maysamsgx/one-robot-speak-control-avoid/Project_Stage3.docx

COE304 Embedded Systems Project Proposal

Spring 2025

Hardware and Software Integration (Phase 3)

Project Name: One Robot, Endless Possibilities | Speak, Control, Avoid

Group No: 10

| Student ID | Student Name
| 210901038 | Beyza Nur Yazıcı
| 210901016 | İrem Batıgün
| 220901646 | Misem Mohamed

1. Software that meets your Requirements

Write the code for your project in C or Assembly to achieve the second stage requirements. Be specific for each one. Fill the following table.

RQ1 | 1. Measure distance using ultrasonic sensor.
| Example: This requirement has been achieved by the following code which triggers the ultrasonic sensor and reads the echo pulse duration to calculate distance in centimeters. // Trigger ultrasonic pulse and read echo time, return distance in cm int readUltrasonic() { digitalWrite(TRIG_PIN, LOW); delayMicroseconds(4); digitalWrite(TRIG_PIN, HIGH); delayMicroseconds(10); digitalWrite(TRIG_PIN, LOW); long duration = pulseIn(ECHO_PIN, HIGH); // Measure echo pulse width return duration / 29 / 2; // Convert microseconds to cm }
RQ2 | 2. Control servo motor to scan left, right, and center positions smoothly.
| Example: This requirement has been achieved by smoothly moving the servo to a target angle one degree at a time with a small delay, ensuring smooth motion. // Smoothly increment or decrement servo until reaching targetAngle void smoothServoWrite(int targetAngle) { int current = servo.read(); // Get current servo angle while (current != targetAngle) { if (current < targetAngle) current++; else current--; servo.write(current); // Move one degree at a time delay(5); // Small delay for smooth motion } }
RQ3 | 3. Perform autonomous obstacle avoidance by detecting obstacles and turning accordingly.

Example: This requirement is met by stopping if an obstacle is closer than 12 cm, backing up, scanning left and right distances, then turning toward the side with more space.

// Continuously check distance ahead and steer around obstacles

void autonomousObstacleAvoidance() {

int frontDistance = readUltrasonic(); // Measure distance ahead

if (frontDistance <= 12) { // If obstacle is closer than 12 cm

stopMotion(); // Stop forward motion

moveBackward(); // Back up slightly

delay(100);

stopMotion();

// Scan left and right distances by moving servo

int leftDistance = scanAt(LEFT_ANGLE);

int rightDistance = scanAt(RIGHT_ANGLE);

smoothServoWrite(CENTER_ANGLE); // Re-center servo

delay(200);

// Turn toward the side with more free space

if (leftDistance > rightDistance) {

Serial.println("Turning left");

turnLeft();

} else {

Serial.println("Turning right");

turnRight();

}

delay(TURN_DURATION_MS); // Run turn long enough for ~90°

stopMotion();

delay(200);

}

else {

moveForward(); // No obstacle → keep moving forward

}

}
RQ4 | 4. Control four DC motors for forward, backward, left, right, and stop motions.

Example: This requirement is fulfilled by functions that run the motors in the appropriate directions using the Adafruit Motor Shield library.

// Drive all four motors forward

void moveForward() {

motor1.run(FORWARD); motor2.run(FORWARD);

motor3.run(FORWARD); motor4.run(FORWARD);

}

// Drive all four motors backward

void moveBackward() {

motor1.run(BACKWARD); motor2.run(BACKWARD);

motor3.run(BACKWARD); motor4.run(BACKWARD);

}

// Spin in place to the right: left wheels backward, right wheels forward

void turnRight() {

motor1.run(BACKWARD); motor2.run(BACKWARD);

motor3.run(FORWARD); motor4.run(FORWARD);

}

// Spin in place to the left: left wheels forward, right wheels backward

void turnLeft() {

motor1.run(FORWARD); motor2.run(FORWARD);

motor3.run(BACKWARD); motor4.run(BACKWARD);

}

// Stop all motors immediately

void stopMotion() {

motor1.run(RELEASE); motor2.run(RELEASE);

motor3.run(RELEASE); motor4.run(RELEASE);

}
RQ5 | 5. Accept manual movement commands via serial input and execute corresponding actions.

Example: This requirement is met by reading serial input characters and calling movement functions based on the command received.

void loop() {

// If a byte arrives on Serial, handle it as a manual command

if (Serial.available() > 0) {

char cmd = Serial.read(); // Read single character

Serial.print("Command received: ");

Serial.println(cmd);

handleCommand(cmd); // Execute manual control

}

else {

autonomousObstacleAvoidance(); // No command → do obstacle avoidance

}

}

// Interpret Bluetooth or voice command characters

void handleCommand(char c) {

switch (c) {

case 'F': case '^': // 'F' or '^' means go forward

Serial.println("Forward");

moveForward();

break;

case 'B': case '-': // 'B' or '-' means go backward

Serial.println("Backward");

moveBackward();

break;

case 'L': case '<': // 'L' or '<' means turn left

Serial.println("Left");

turnLeft();

break;

case 'R': case '>': // 'R' or '>' means turn right

Serial.println("Right");

turnRight();

break;

case 'S': case '*': // 'S' or '*' means stop

Serial.println("Stop");

stopMotion();

break;

default: // Any other char → emergency stop

stopMotion();

break;

}

}
RQ6
| 6. Set motor speed to a fixed PWM value for consistent movement.
| Example: This requirement is achieved by setting the speed of all motors to 180 during setup. #define MOTOR_SPEED 180 // PWM speed for all four DC motors (0–255) // Initialize all motors at defined speed motor1.setSpeed(MOTOR_SPEED); motor2.setSpeed(MOTOR_SPEED); motor3.setSpeed(MOTOR_SPEED); motor4.setSpeed(MOTOR_SPEED);
RQ7 | 7. Provide serial feedback on received commands.
| Example: This requirement is met by printing the received command and action to the serial monitor. char cmd = Serial.read(); // Read single character Serial.print("Command received: "); Serial.println(cmd);
RQ8 | 8. Provide a default safe state when unknown commands are received.
| Example: The system stops all motors immediately if an unrecognized command is received, preventing unsafe behavior. default: // Any other char → emergency stop stopMotion(); break;
RQ9 | 9. Use delays appropriately to allow hardware to settle and avoid timing issues.
| Example: Delays after servo movement and motor commands ensure sensors and actuators have time to respond. // Wait after servo moves before reading sensor to Run turn long enough for ~90° delay(TURN_DURATION_MS); // Allow servo to settle delay(SCAN_DELAY_MS);
RQ10 | 10. Modularize code for clarity and maintainability.
| Example: Each functionality (movement, scanning, command handling) is encapsulated in dedicated functions, improving readability and testability. void scanAt(int angle) { ... } void smoothServoWrite(int targetAngle) {…} void handleCommand(char c) { ... } void autonomousObstacleAvoidance() {...} void moveForward() { ... } void moveBackward() {…} void turnRight() {...} void turnLeft() {…} void stopMotion() {…}
RQ11 | 11. System shall operate continuously without manual reset.
| Example: The loop() function runs indefinitely, continuously checking for commands or performing autonomous navigation. void loop() { // If a byte arrives on Serial, handle it as a manual command if (Serial.available() > 0) { char cmd = Serial.read(); // Read single character Serial.print("Command received: "); Serial.println(cmd); handleCommand(cmd); // Execute manual control } else { autonomousObstacleAvoidance(); // No command → do obstacle avoidance } }

2. HW and SW Integration

Integrate the hardware components with the Arduino board and uploading the code to the board for testing. Write down any challenge or error you faced and how did you solve it.

| Challenge or Error | How did you solve it?

Bluetooth Module Availability and Hardware Compatibility

Initially, we were unable to find the Bluetooth module in local markets, as it was frequently out of stock. As a temporary solution, we borrowed an ESP32 Wi-Fi + Bluetooth module. Upon researching its specifications, we found that it offered superior performance compared to the HC-05. However, it also required a more complex wiring setup, which did not align well with our existing design. To maintain our original hardware layout, we eventually sourced an HC-05 module. This module also required soldering in order to interface with the motor driver shield, but compared to the DC motor connections, the soldering process was significantly simpler and more straightforward.

Encoder Disc

Absence

To address the encoder disk shortage, we carefully measured the only available encoder disk and recreated its exact geometry using ShapeWorks. After finalizing the design, we utilized a 3D printer to fabricate four new encoder disks based on the model. This approach allowed us to successfully replicate all the encoder disks, using just a single physical sample as a reference.

However, we initially implemented the encoder without thoroughly researching its purpose and functionality. Later, we realized that our project does not require advanced features such as:

- Precise distance measurement (e.g., moving exactly 30 cm),
- Linear positioning or navigation,
- Speed control or PID motor control,
- Simultaneous Localization and Mapping (SLAM),
- Odometric position tracking.

Despite this, we decided to retain the newly designed encoder disks in our build to support future development and potential feature expansion. By doing so, we ensured our design remains flexible and scalable should more complex capabilities be added later.
| Lack of Screws | The package we received was missing the screws required to mount the motors, which caused difficulties in securing them to the chassis. There were several alternative solutions, such as using super glue, tying the motors to the chassis with plastic cable ties, or sourcing replacement screws. Ultimately, we chose to purchase or borrow the correct screws, as this was the most reliable and durable option for ensuring mechanical stability.
| Shipping Damage on L293D Shield | The pins of the L293D motor driver shield arrived bent due to shipping damage. To straighten them without causing further damage, we used a pair of needle-nose pliers. This allowed us to carefully realign the bent pins without breaking or weakening them.
| A Detached Ground Wire In the Servo Motor | Although we tested it and confirmed it was working, we decided to use a brand-new servo, as we believed the condition of the wire could lead to potential inconsistencies.
| Stability of the Ultrasonic Sensor and Servo Motor | The ultrasonic sensor was required to be mounted on top of the servo motor, making the servo act as the structural base. Therefore, it needed to be firmly secured. We achieved this by fastening it to the car chassis using multiple screws and the pre-drilled mounting holes. To mount the ultrasonic sensor itself, we utilized a dedicated holder, which allowed attachment to the servo using double-sided adhesive tape. However, ensuring mechanical balance was challenging, the setup frequently tipped forward or backward during operation, requiring repeated adjustments to maintain stability.

Not pre-wired DC Motors

The DC motors we received did not come with pre-attached wires, so we had to manually solder the connections. In order to perform proper soldering, we first familiarized ourselves with basic soldering techniques, including tinning the wire tips, preheating the joint area, and applying the solder to the heated surfaces rather than the iron directly. However, during the initial soldering process, we overlooked critical aspects such as wire polarity and color orientation. This oversight led to a wiring mismatch, which we only identified later when we faced difficulties connecting the motors to the motor driver. As a result, we had to desolder the initial connections and perform a second round of soldering, this time ensuring correct polarity alignment and mechanically stable joints to guarantee reliable motor driver operation

Challenges in Connecting DC Motors to Motor Shield

Connecting the DC motors to the motor shield proved to be a time-consuming task, mainly due to the lack of clear and consistent tutorials or documentation. We struggled to determine the correct wiring order and polarity for the motor terminals, and it was unclear how critical the wire sequence was. In some reference materials, the middle terminal was shown as a pinned GND, making it inaccessible—yet in our version, the layout differed, further adding to the confusion. We were forced to try multiple wiring combinations through trial and error to identify the correct configuration. Additionally, due to inconsistent soldering and poor tip shaping on the wire ends, inserting the wires into the shield terminals was physically difficult, often resulting in unstable or unreliable connections. During this process, the wheels often rotated in the wrong direction or failed to move altogether, which significantly delayed our progress.
| Upload Failure Due to Serial Pin Interference (D0/D1 Conflict) | After completing our connections and attempting to upload the code to the Arduino, the upload consistently failed despite all our validations. Upon further investigation, we discovered the issue was caused by a common mistake: something was connected to pins D0 (RX) and D1 (TX) during the upload process. These pins are used for serial communication between the Arduino and the computer and must remain unconnected when uploading code. In our case, the Bluetooth module was still attached to those pins, which interfered with the upload process.

Servo Malfunction Due to Timer Conflict on Motor Shield

We initially connected our servo motor to the SERVO_1 port on the motor shield, but it didn’t function correctly. Upon further research, we found that on motor shields like the Adafruit Motor Shield v1/v2, certain pins serve special purposes. The SERVO_1 and SERVO_2 ports are designated for servo output and are compatible with the Servo library. However, pins like D9 and D10 can lead to conflicts when used with both motors and servos, as they share the same internal timer. In our case, connecting the servo to SERVO_1 (Arduino pin 10) caused such a conflict. The recommended solution was to switch the connection to SERVO_2 (Arduino pin 9), which is better suited for servo control without timing conflicts. After doing so, the servo operated as expected.

Connection problem with Bluetooth module

The Bluetooth module we purchased did not ask for a PIN code on first use and could not be configured in any way. After researching, we found that it might be a clone, which can cause such issues. Therefore, we borrowed another module, but even though this one was original, we still faced connection problems. When we couldn’t solve the issue ourselves, we asked you for help, and you showed us that Bluetooth can often cause unexpected issues — there are even special debugging tools made just for this. You reset the Bluetooth pairing on the phone and re-paired it, which resolved the problem. Since then, we have not experienced any further issues.

Forget to buy a switch – the robot couldn’t be stopped without removing the battery, and autonomous behavior was disrupted

We solved this purely in software with two approaches:
1. On-demand autonomy – In loop() we check Serial.available(). If there’s input, we call handleCommand(cmd) (forward/back/left/right/stop); if not, we call autonomousObstacleAvoidance(). This both disables obstacle avoidance during manual control and provides an emergency-stop path without pulling the battery.
2. Explicit modes – Maintain a mode variable (Obstacle / Bluetooth / Voice) and switch on special commands. We rejected this due to added state-machine complexity.
We chose option 1 for its simplicity, seamless hand-off, built-in emergency stop, and easier debugging (all logic in one control flow).

3. Testing and Debugging:

Emphasize the importance of testing each component and functionality of the project code thoroughly to identify and fix any errors or bugs (if any). You can add photos or videos.

Thorough testing and debugging of each component is a critical step in embedded systems development. It ensures system reliability, correct behavior, function and smooth integration of all modules. In our project, we followed a modular approach to verify the functionality of each part individually before combining them.

1. Servo Motor Testing

We began by testing the servo motor, which is responsible for carrying the ultrasonic sensor to scan the environment left and right for obstacle detection. We wrote a script to sweep the servo from 0° to 180° and back in 1° increments. This allowed us to confirm that the servo responds smoothly and consistently to angle commands.

Observation: The motor arm rotated as expected, demonstrating that the pin connection (D9), PWM signal, and power supply were functioning correctly.

Result: No jittering or delays were observed, verifying that the servo could later be used for scanning in the robotic car.

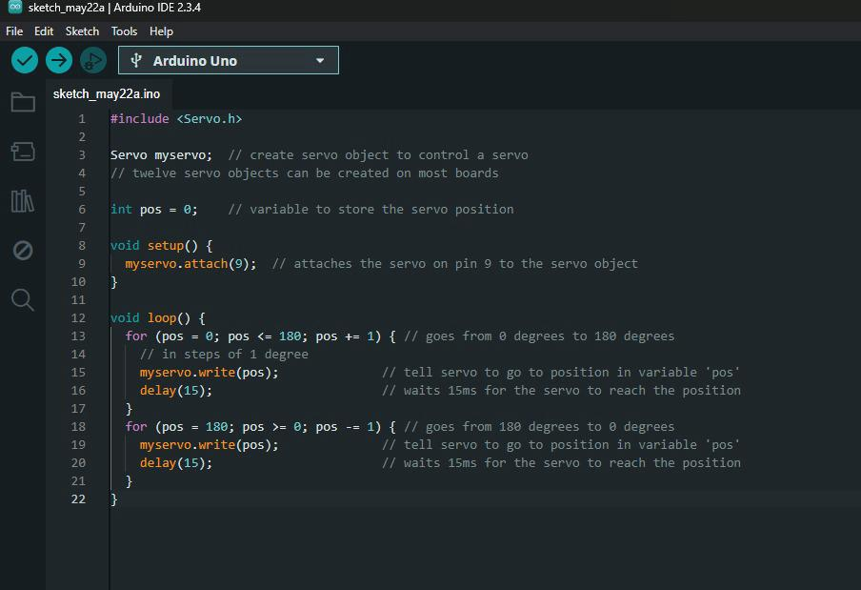
[picture p3: figure]
metin, ekran görüntüsü, yazılım, multimedya yazılımı içeren bir resim Yapay zeka tarafından oluşturulan içerik yanlış olabilir.

Link to video with test result of Servo Motor: https://istinye-my.sharepoint.com/:v:/g/personal/210901038_stu_istinye_edu_tr/EW9BHaciSRtEtWb2v8HnXpIBxT5TJh-lczQ1BDwhIgzclA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

2. Ultrasonic Sensor Testing

Next, the ultrasonic sensor (HC-SR04) was tested independently to verify its ability to accurately detect distances. A simple Arduino sketch was used to trigger the sensor and display real-time distance measurements on the Serial Monitor. This test helped identify any potential wiring or signal issues before integrating the sensor into the full system.

Observation: When a stick was moved closer, the values on the monitor changed in real time.

Result: The sensor accurately detected distances, ranging from a few centimeters to over 400 cm.

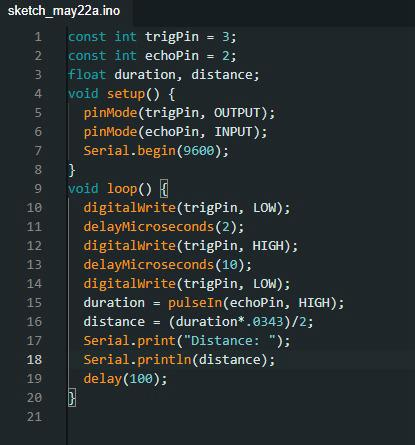
[picture p4: figure]
metin, ekran görüntüsü, yazı tipi içeren bir resim Yapay zeka tarafından oluşturulan içerik yanlış olabilir.
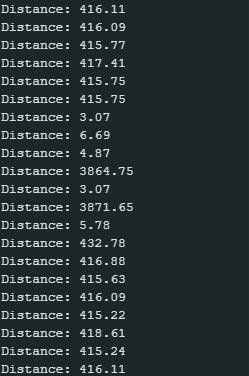
[picture p5: figure]
metin, ekran görüntüsü, menü, siyah beyaz içeren bir resim Yapay zeka tarafından oluşturulan içerik yanlış olabilir.

Link to video with test result of Ultrasonic Sensor : https://istinye-my.sharepoint.com/:v:/g/personal/210901038_stu_istinye_edu_tr/EaSmJB6na35IiEGWLtGp92YBGHqrj38f1gEFiwWb9j1QCA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

3. Bluetooth Module Testing

Bluetooth module (HC-05), which facilitates wireless control of the robotic car via smartphone. This test was essential to ensure stable serial communication and proper pairing functionality before system integration.

Test Method: We used a simple program to turn an LED on/off by sending '1' and '0' via the serial monitor or Bluetooth terminal app.

Observation: The green LED toggled successfully in response to commands. The RX/TX communication with the HC-05 was verified through the blinking onboard LED on the module.

Result: This confirmed successful Bluetooth pairing and serial data reception.

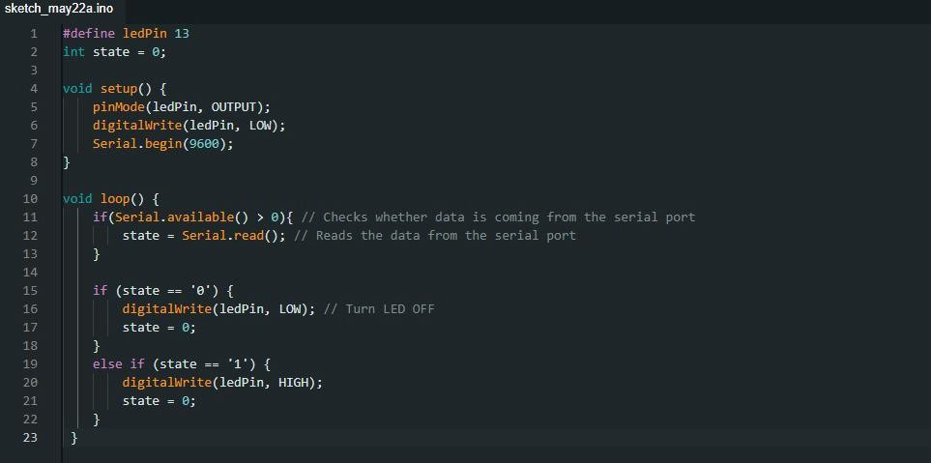
[picture p6: figure]
metin, ekran görüntüsü, yazılım, multimedya yazılımı içeren bir resim Yapay zeka tarafından oluşturulan içerik yanlış olabilir.
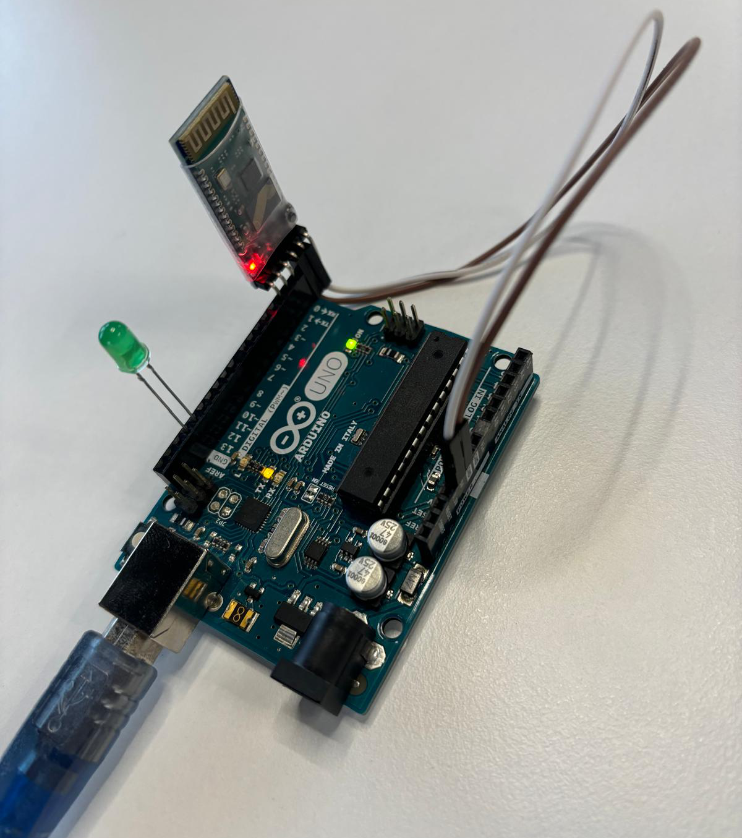
[picture p7: figure]
elektronik mühendisliği, elektronik donanım, devre bileşeni, elektronik bileşen içeren bir resim Yapay zeka tarafından oluşturulan içerik yanlış olabilir.

4. DC Gear Motor Testing

The DC motors arrived without wires, so we soldered wires to the motor terminals to enable connectivity. Then, we soldered the other ends of the wires to allow connection to the motor shield. This ensured a reliable and durable connection between the motors and the shield for consistent power delivery and control.

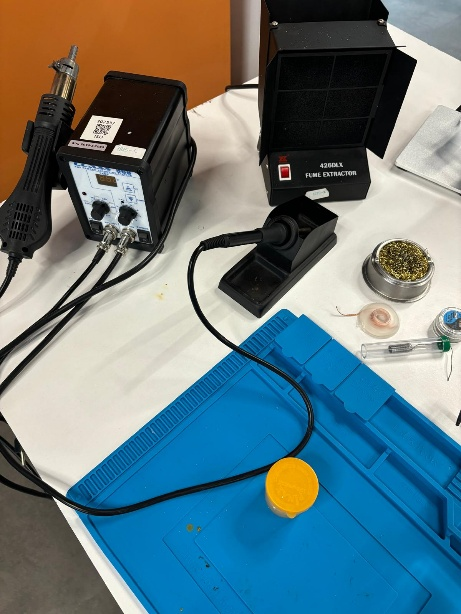
[picture p8: figure]
iç mekan, kablo, bilgisayar, ofis malzemesi içeren bir resim Yapay zeka tarafından oluşturulan içerik yanlış olabilir.
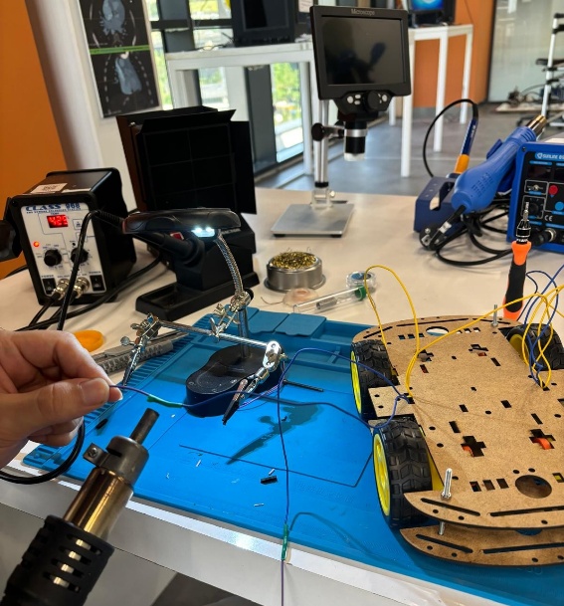
[picture p9: figure]
iç mekan, makine, alet, mühendislik içeren bir resim Yapay zeka tarafından oluşturulan içerik yanlış olabilir.
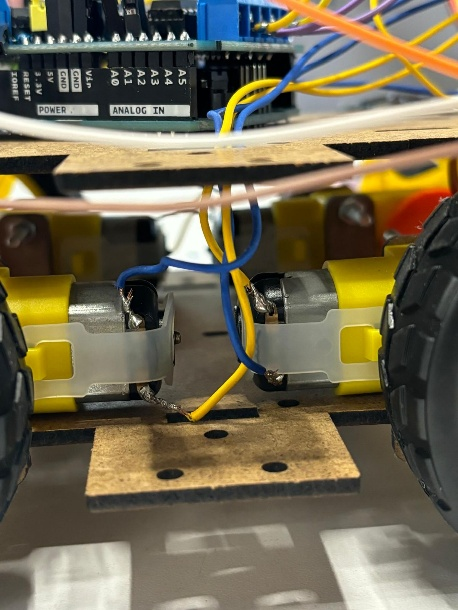
[picture p10: figure]
araba lastiği, tekerlek, Araba parçası, makine içeren bir resim Yapay zeka tarafından oluşturulan içerik yanlış olabilir.
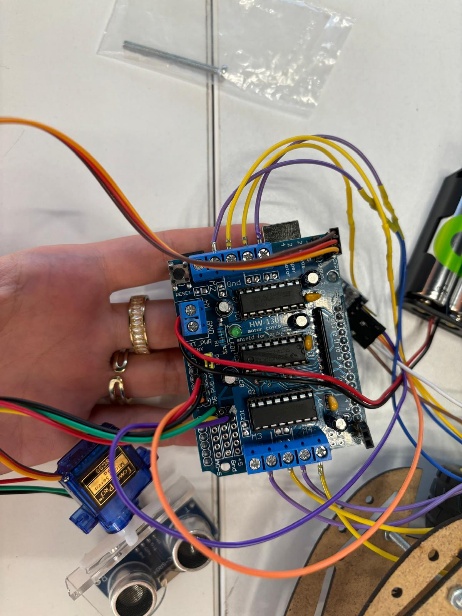
[picture p11: figure]
elektronik mühendisliği, elektronik donanım, Elektrik kabloları, devre içeren bir resim Yapay zeka tarafından oluşturulan içerik yanlış olabilir.

To validate the movement and control logic of the robotic car, we performed isolated testing of the four DC gear motors.

Test Procedure:

We created a loop that commands the car to:

Turn right for 5 seconds, turn left for 5 seconds, move backward for 5 seconds and move forward for 5 seconds. Between each action, the car stops momentarily to ensure clear transitions.

Observations: All motors responded correctly to their respective direction commands. The car performed each movement (turns and straight motion) accurately without any delay or missed signals.

Serial prints (e.g., "Turning left", "Moving forward") confirmed the execution flow in real-time through the Serial Monitor.

Results: Motor polarity and wiring are correctly configured.

The robotic car is physically capable of executing the full set of movement commands (forward, backward, left, right, stop).

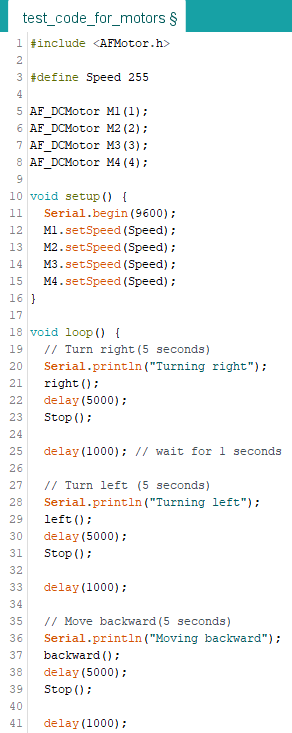
[picture p12: figure]
metin, ekran görüntüsü, yazı tipi, sayı, numara içeren bir resim Yapay zeka tarafından oluşturulan içerik yanlış olabilir.
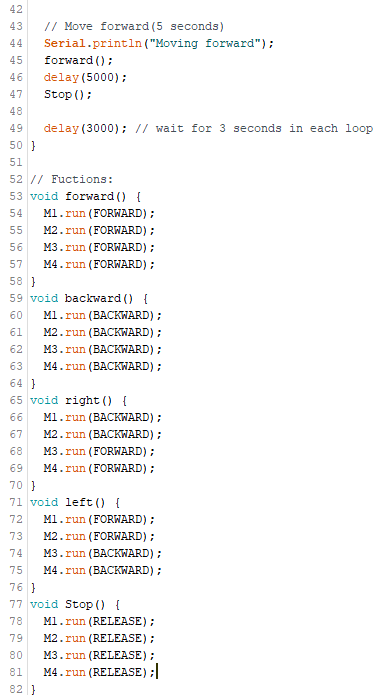
[picture p13: figure]
metin, ekran görüntüsü, sayı, numara, yazı tipi içeren bir resim Yapay zeka tarafından oluşturulan içerik yanlış olabilir.

Link to video with test result of DC Gear Motor : https://istinye-my.sharepoint.com/:v:/g/personal/210901038_stu_istinye_edu_tr/EY8MHk5t5SxEvHujQW8FcQEBdrNx3HKMUmJ0mkOIEWiACQ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

5. Battery and Power Supply Testing

Power supply is one of the most critical elements in embedded and mobile robotics projects, as it directly affects the reliability, performance, and safety of the entire system. For our robotic car, which integrates all components of the robotic car, stable and sufficient power is essential for proper, consistent and safe operation. Before integrating the battery pack into the mobile system, we conducted controlled testing using a regulated DC power supply to simulate expected voltage loads.

In the lab setup (as shown in the photo), we powered the system using a bench power supply set to 6V. This allowed us to monitor the real-time voltage and current drawn by the motors and logic components. The multimeter ensured that voltage fluctuations reducing the risk of hardware damage.

After confirming that the system could operate stably at 6V, we switched to a battery pack (4x1.5V AA batteries) as the portable power source for the car. The battery output was verified to match the voltage requirements of the motor driver and the Arduino board. Stable operation from both power sources confirmed that our wiring, voltage levels, and consumption were within safe limits.

Key Checks Performed:

- Verified 6V from the lab power supply to match motor and controller requirements.
- Ensured all motors responded with sufficient torque under load.

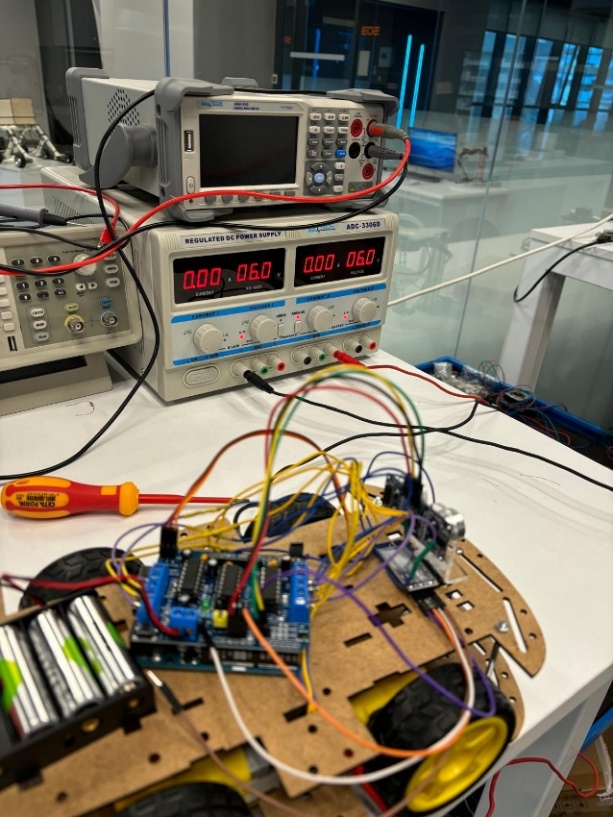
[picture p14: figure]
elektronik donanım, elektronik mühendisliği, Elektrik kabloları, kablo içeren bir resim Yapay zeka tarafından oluşturulan içerik yanlış olabilir.

4. Documentation: document your project, including
- The circuit diagram

We constructed our robotic car system according to the Fritzing circuit diagram we made in the 2nd Satge of the Project. This schematic guided the correct wiring and integration of all major components, including the Arduino Uno board, HC-05 Bluetooth module, servo motor, ultrasonic sensor, L293D motor driver shield, and gear motors powered by four Li-ion batteries.

Each connection was carefully made to ensure proper communication and power delivery between the components. The motor driver shield was placed on top of the Arduino Uno to control the four DC gear motors, while the Bluetooth module enabled wireless control. The ultrasonic sensor, mounted on a servo motor, provided real-time environmental scanning for obstacle avoidance.

In addition to the circuit schematic, we have also included real images of the final assembled car. These images highlight the physical placement of all components, including the battery holder, sensor modules, wiring setup, and chassis structure. This final prototype reflects a successful translation of our digital design into a functional embedded system.

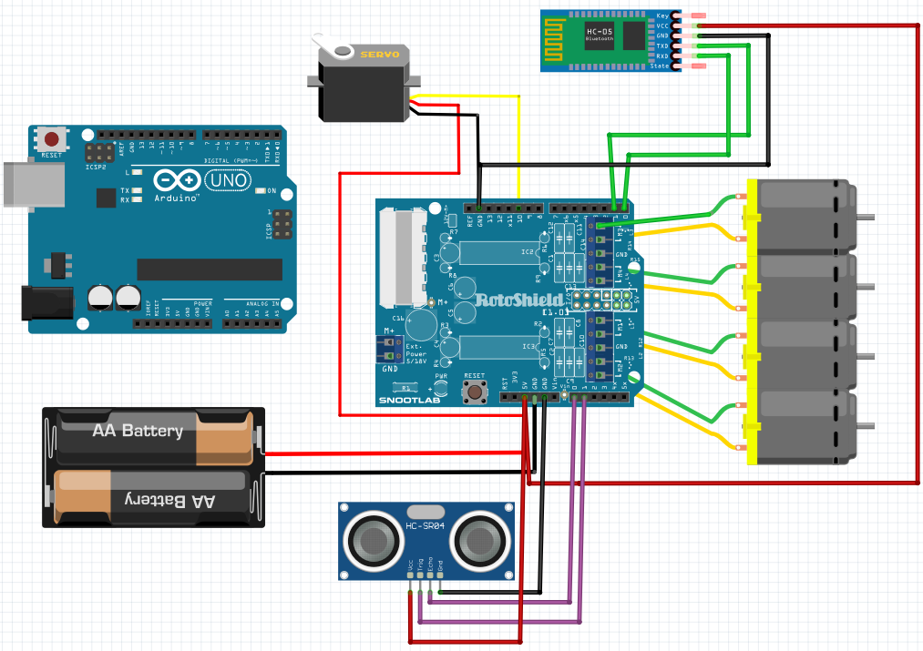
[picture p15: figure]
metin, diyagram, elektronik mühendisliği, plan içeren bir resim Yapay zeka tarafından oluşturulan içerik yanlış olabilir.
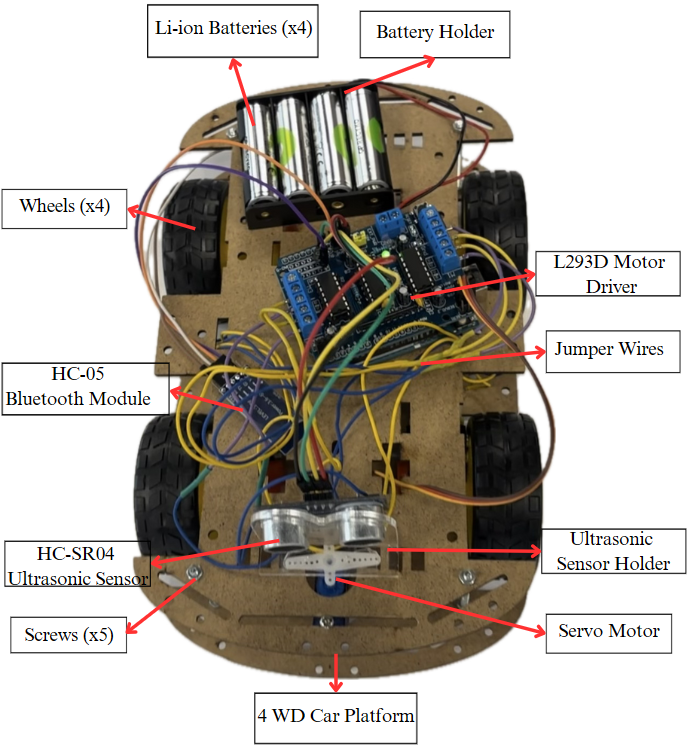
[picture p16: figure]
metin, devre, elektronik mühendisliği, ekran görüntüsü içeren bir resim Yapay zeka tarafından oluşturulan içerik yanlış olabilir.
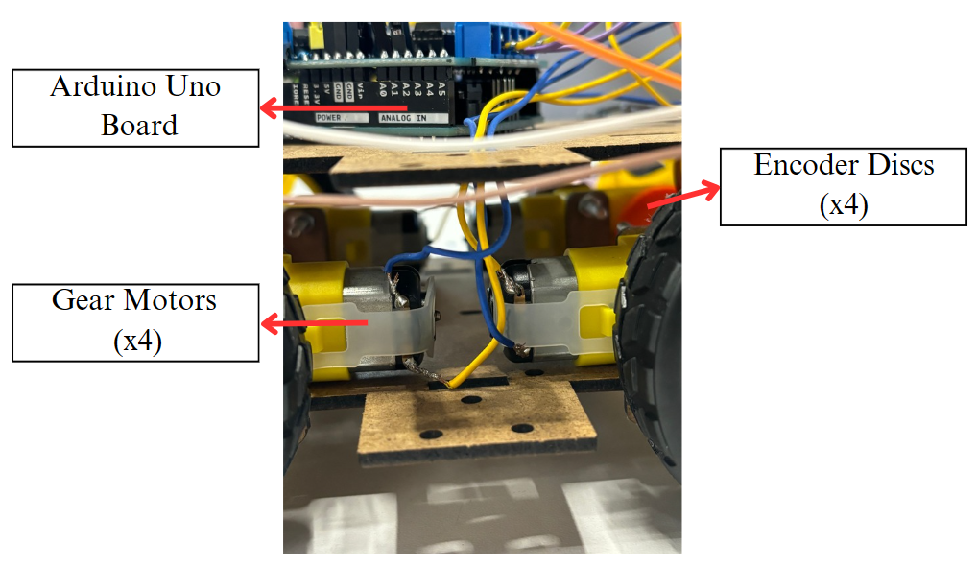
[picture p17: figure]
ekran görüntüsü, metin, makine içeren bir resim Yapay zeka tarafından oluşturulan içerik yanlış olabilir.

- Code explanation with comments
- #include <Servo.h> // Include Servo library for controlling the servo motor
- #include <AFMotor.h> // Include Adafruit Motor Shield library for DC motors
- // Pin definitions
- #define ECHO_PIN A0 // Ultrasonic sensor echo pin
- #define TRIG_PIN A1 // Ultrasonic sensor trigger pin
- #define SERVO_PIN 9 // Servo signal pin (Arduino D9)
- #define MOTOR_SPEED 180 // PWM speed for all four DC motors (0–255)
- // Servo angles and timing constants
- #define LEFT_ANGLE 150 // Servo angle to scan left side
- #define RIGHT_ANGLE 30 // Servo angle to scan right side
- #define CENTER_ANGLE 103 // Servo “home” or center position
- #define SCAN_DELAY_MS 400 // Delay after moving servo before reading distance
- #define TURN_DURATION_MS 450 // How long to run motors to achieve ~90° turn
- // Create global objects
- Servo servo; // Servo object
- AF_DCMotor motor1(1), // Motor shield channel 1
- motor2(2), // Motor shield channel 2
- motor3(3), // Motor shield channel 3
- motor4(4); // Motor shield channel 4
- void setup() {
- Serial.begin(9600); // Start serial communication at 9600 baud
- pinMode(TRIG_PIN, OUTPUT); // Set trigger pin as output
- pinMode(ECHO_PIN, INPUT); // Set echo pin as input
- servo.attach(SERVO_PIN); // Attach servo to its pin
- smoothServoWrite(CENTER_ANGLE); // Move servo to center on startup
- // Initialize all motors at defined speed
- motor1.setSpeed(MOTOR_SPEED);
- motor2.setSpeed(MOTOR_SPEED);
- motor3.setSpeed(MOTOR_SPEED);
- motor4.setSpeed(MOTOR_SPEED);
- }
- void loop() {
- // If a byte arrives on Serial, handle it as a manual command
- if (Serial.available() > 0) {
- char cmd = Serial.read(); // Read single character
- Serial.print("Command received: ");
- Serial.println(cmd);
- handleCommand(cmd); // Execute manual control
- }
- else {
- autonomousObstacleAvoidance(); // No command → do obstacle avoidance
- }
- }
- // Interpret Bluetooth or voice command characters
- void handleCommand(char c) {
- switch (c) {
- case 'F': case '^': // 'F' or '^' means go forward
- Serial.println("Forward");
- moveForward();
- break;
- case 'B': case '-': // 'B' or '-' means go backward
- Serial.println("Backward");
- moveBackward();
- break;
- case 'L': case '<': // 'L' or '<' means turn left
- Serial.println("Left");
- turnLeft();
- break;
- case 'R': case '>': // 'R' or '>' means turn right
- Serial.println("Right");
- turnRight();
- break;
- case 'S': case '*': // 'S' or '*' means stop
- Serial.println("Stop");
- stopMotion();
- break;
- default: // Any other char → emergency stop
- stopMotion();
- break;
- }
- }
- // Continuously check distance ahead and steer around obstacles
- void autonomousObstacleAvoidance() {
- int frontDistance = readUltrasonic(); // Measure distance ahead
- if (frontDistance <= 12) { // If obstacle is closer than 12 cm
- stopMotion(); // Stop forward motion
- moveBackward(); // Back up slightly
- delay(100);
- stopMotion();
- // Scan left and right distances by moving servo
- int leftDistance = scanAt(LEFT_ANGLE);
- int rightDistance = scanAt(RIGHT_ANGLE);
- smoothServoWrite(CENTER_ANGLE); // Re-center servo
- delay(200);
- // Turn toward the side with more free space
- if (leftDistance > rightDistance) {
- Serial.println("Turning left");
- turnLeft();
- } else {
- Serial.println("Turning right");
- turnRight();
- }
- delay(TURN_DURATION_MS); // Run turn long enough for ~90°
- stopMotion();
- delay(200);
- }
- else {
- moveForward(); // No obstacle → keep moving forward
- }
- }
- // Trigger ultrasonic pulse and read echo time, return distance in cm
- int readUltrasonic() {
- digitalWrite(TRIG_PIN, LOW);
- delayMicroseconds(4);
- digitalWrite(TRIG_PIN, HIGH);
- delayMicroseconds(10);
- digitalWrite(TRIG_PIN, LOW);
- long duration = pulseIn(ECHO_PIN, HIGH); // Measure echo pulse width
- return duration / 29 / 2; // Convert microseconds to cm
- }
- // Move servo to a specified angle, wait, then measure distance
- int scanAt(int angle) {
- smoothServoWrite(angle); // Rotate servo smoothly
- delay(SCAN_DELAY_MS); // Allow servo to settle
- return readUltrasonic(); // Return measured distance
- }
- // Smoothly increment or decrement servo until reaching targetAngle
- void smoothServoWrite(int targetAngle) {
- int current = servo.read(); // Get current servo angle
- while (current != targetAngle) {
- if (current < targetAngle) current++;
- else current--;
- servo.write(current); // Move one degree at a time
- delay(5); // Small delay for smooth motion
- }
- }
- // Drive all four motors forward
- void moveForward() {
- motor1.run(FORWARD); motor2.run(FORWARD);
- motor3.run(FORWARD); motor4.run(FORWARD);
- }
- // Drive all four motors backward
- void moveBackward() {
- motor1.run(BACKWARD); motor2.run(BACKWARD);
- motor3.run(BACKWARD); motor4.run(BACKWARD);
- }
- // Spin in place to the right: left wheels backward, right wheels forward
- void turnRight() {
- motor1.run(BACKWARD); motor2.run(BACKWARD);
- motor3.run(FORWARD); motor4.run(FORWARD);
- }
- // Spin in place to the left: left wheels forward, right wheels backward
- void turnLeft() {
- motor1.run(FORWARD); motor2.run(FORWARD);
- motor3.run(BACKWARD); motor4.run(BACKWARD);
- }
- // Stop all motors immediately
- void stopMotion() {
- motor1.run(RELEASE); motor2.run(RELEASE);
- motor3.run(RELEASE); motor4.run(RELEASE);
- }
- Testing results and debugging via terminal

To validate the functionality of our voice-controlled, RC command-controlled and obstacle-avoiding robotic car, we have prepared demonstration videos showcasing the three main features of the system. Each video highlights aspects of the car's operation and how it responds to user input and environmental conditions. Below are the links and explanations corresponding to each demo video.

1. Voice Control Demonstration

In these videos, we demonstrate the voice command capability of the robotic car. Using a smartphone voice recognition application which is Arduino BlueControl, we gave verbal commands such as:

"Go" → The car moves forward

"Back" → The car moves backward

"Left" → The car turns left

"Right" → The car turns right

"Stop" → The car halts immediately

The car receives these commands via Bluetooth and responds in real-time, showcasing the integration of speech recognition with the embedded motor control system. This feature offers a hands-free control mechanism, making the system especially useful for individuals with limited mobility.

Links to videos with the result :

https://istinye-my.sharepoint.com/:v:/g/personal/210901038_stu_istinye_edu_tr/EdbA3dY4Sh5LnX5B5h9uxxgBD3hFwqPUG_xiSeq6Wd6sQg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

https://istinye-my.sharepoint.com/:v:/g/personal/210901038_stu_istinye_edu_tr/Ec5eDj6AKCtDruNDsj4tLP8BL12cUQJRjZaWA9I2cEoTPQ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

https://istinye-my.sharepoint.com/:v:/g/personal/210901038_stu_istinye_edu_tr/EV1hSvOOM4ZHjNe_QoXd99QBga31-LXje2_ik_iyccbztw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

2. Obstacle Avoidance Demonstration

This video highlights the autonomous obstacle avoidance system of the robotic car. The HC-05 ultrasonic sensor mounted on a servo motor continuously scans the front, left, and right directions. When the sensor detects an object within 12 cm, the car automatically:

Stops and reverses briefly to avoid collision

Rotates the servo to scan left and right directions

Decides the direction with more space

Turns toward the obstacle-free side and resumes forward motion

This behavior demonstrates the car’s ability to navigate complex environments without human intervention, making it suitable for autonomous applications.

Links to videos with the result:

https://istinye-my.sharepoint.com/:v:/g/personal/210901038_stu_istinye_edu_tr/EUxrRUsi5QZAkBE1rk2C5TIBgr5VT4504ZfJFydlzrPocQ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

https://istinye-my.sharepoint.com/:v:/g/personal/210901038_stu_istinye_edu_tr/ES7LfOXSQ4NMjFBfc6wwPhkB-E4dV-xk4Hx36KpczXnVEw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

3. RC Command Control Demonstration

In this demo, we control the car using an RC-style interface called RC Bluetooth Controller. Each button corresponds to a specific command:

Forward

Backward

Turn Left

Turn Right

When buttons are pressed, the car executes the corresponding movement immediately. This showcases the system’s manual control mode, allowing for precise driving and testing. It also validates the reliability of the Bluetooth communication and motor control responses.

Link to video with the result:

https://istinye-my.sharepoint.com/:v:/g/personal/210901038_stu_istinye_edu_tr/EcfI7Dr5fBtNijSTj8aWazkB-A1kogPZzn33xD93hjqZYw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

Each of these demo videos clearly illustrates the core functionalities of our project and collectively proves that the system operates effectively under all three control scenarios: voice-driven, autonomous, and manual.

- Any modifications made during the optimization process

1. Servo scan angles

  - Original: rightsee at 20°, leftsee at 180°.
  - Trials:
    - #define SERVO_LEFT 160 / #define SERVO_RIGHT 30
    - 135° / 45°
  - Final: settled on 150° (left) and 30° (right) for the best balance between field of view and mechanical limits.

2. Obstacle‐detection threshold

  - Tested distances: 12 cm, 18 cm, 20 cm
  - Chosen value: 12 cm gave the most reliable avoidance without excessive early turning.

3. Speed and timing constants

3.1 Servo scan delay (SCAN_DELAY_MS = 400 ms)

- Typical analog servos spin at ≈300°/s → ≈3.3 ms per degree.
- We sweep ±60° (30° → 150°), so 60° ≃ 200 ms.
- Doubling to 400 ms gives ample settling time and lets the ultrasonic echo stabilize, cutting down on noisy readings.

3.2 Turn duration (TURN_DURATION_MS ≃ 450 ms)

- Forum baseline: 90° spin at full PWM (255) ≃ 300 ms.
- Our PWM=180 is ≈ 70% of 255, so ideal time ≃ 300 ms × (180/255) ≃ 212 ms.
- Real-world factors (battery sag, friction, inertia) demand extra margin: doubled to ≃ 425 ms and rounded up to 450 ms.

3.3 Motor speed (MOTOR_SPEED = 180 PWM)

- Tested at 255 (100% duty) on a 4×AA pack (~6 V):
  - Led to severe voltage sag/brown-outs under load.
  - Caused servo glitches and repeated resets during high-torque maneuvers.
  - Dramatically cut battery runtime to only a few minutes.
- Settled on 180 PWM (~70% duty) to balance torque, top speed, and stable voltage under load.

4. Calibration & safety margin

These values were established and fine-tuned during on-vehicle testing by ±10–20%:

- SCAN_DELAY_MS was adjusted to eliminate any servo bounce or echo jitter.
- TURN_DURATION_MS was tweaked until 90° turns were consistently accurate.
- MOTOR_SPEED was modified up or down to balance responsiveness with battery life.

Appendix A – Complete Requirements Matrix

ID | Type | Requirement Description | Verification Method
FR1 | Functional Requirement | The robot shall move forward, backward, left, and right using voice commands. | Test voice commands and observe
FR2 | Functional Requirement | The robot shall receive and execute Bluetooth commands from a mobile app. | Pair mobile app and test commands
FR3 | Functional Requirement | The robot shall stop or change direction upon detecting an obstacle using an ultrasonic sensor. | Place obstacles; observe behavior
FR4 | Functional Requirement | The robot shall operate in autonomous navigation mode, avoiding obstacles. | Activate mode; test navigation
FR5 | Functional Requirement | The robot shall switch between manual and autonomous modes upon receiving a specific “mode” command. | Send mode-switch command; verify behavior
FR6 | Functional Requirement | The robot shall rotate its ultrasonic sensor via servo from LEFT_ANGLE to RIGHT_ANGLE before avoidance. | Monitor servo sweep angles on each obstacle encounter
FR7 | Functional Requirement | The robot shall immediately stop upon receiving an emergency stop signal. | Trigger emergency stop; ensure motors release instantly
NFR1 | Non-Functional Requirement | The system shall operate within a voltage range of 5–7 V DC. | Measure input voltage range
NFR2 | Non-Functional Requirement | Obstacle detection response time shall be less than 600 ms (including servo sweep). | Measure end-to-end response with an oscilloscope
NFR3 | Non-Functional Requirement | The robot shall operate continuously for at least 15 minutes on a fully charged battery. | Run endurance test
NFR4 | Non-Functional Requirement | The voice recognition module shall respond to commands with at least 85% accuracy in a quiet environment. | Test recognition accuracy
NFR5 | Non-Functional Requirement | The robot’s total weight shall be less than 1.5 kg to ensure mobility and stability. | Weigh assembled robot
NFR6 | Non-Functional Requirement | The robot shall operate reliably between 0 °C and 40 °C ambient temperature. | Environmental chamber or field test
HSI1 | Hardware-Software Interface | The Arduino shall interface with the L293D motor driver to control the DC motors. | Check wiring and control signals
HSI2 | Hardware-Software Interface | The Arduino shall read obstacle distance from the ultrasonic sensor (e.g., HC-SR04). | Read sensor data via serial output
HSI3 | Hardware-Software Interface | The Arduino shall receive Bluetooth commands via the HC-05 module. | Test Bluetooth communication
HSI4 | Hardware-Software Interface | The Arduino shall send PWM control signals to the servo on pin SERVO_PIN for obstacle scanning. | Verify PWM output on oscilloscope or logic analyzer
HMI1 | Human-Machine Interaction | Users shall give commands through voice or Bluetooth using a mobile app. | Demonstrate both control methods

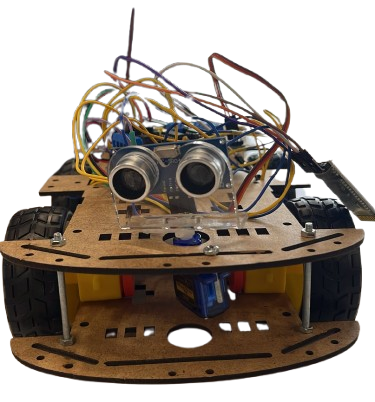
[picture p18: figure]

Appendix B - Datasheets of Sensors (HC-05 and Ultrasonic Sensor) and Motor Shield

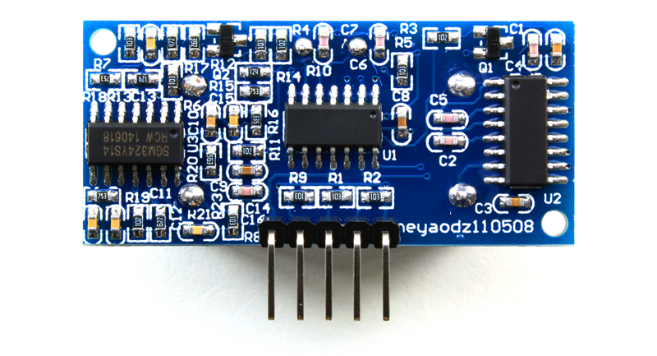
[picture p19: figure]
Ultrasonic Sensor HY-SRF05 - Senith Electronics
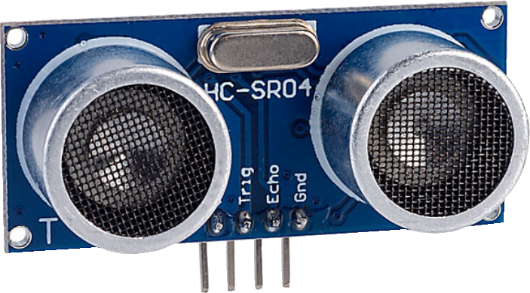
[picture p20: figure]
Programming frc ultrasonic sensor - generatordase

Sir Avoids-a-Lot

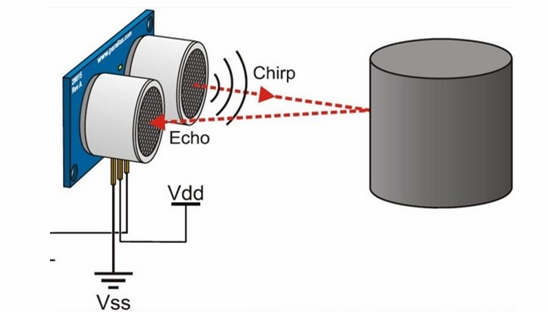
[picture p21: figure]
반돌이's 아두이노 강좌 : 초음파센서 사용하기 : 네이버 블로그
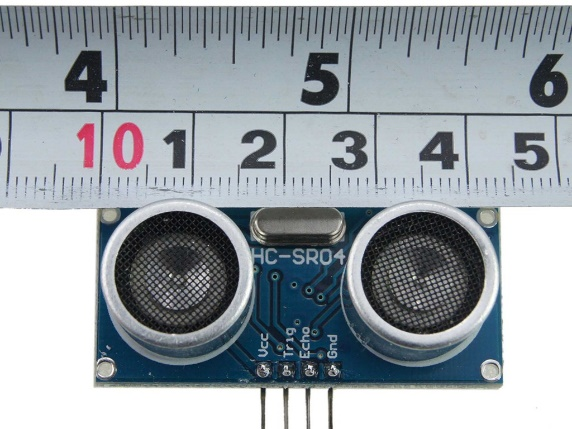
[picture p22: figure]
Buy ultrasonic sensor Module at Affordable Price in Ainow

Ultrasonic Sensor (HC-SR04) Datasheet

- Operating voltage: 5V DC
- Measurement range: 2cm – 400cm
- Accuracy: ±3mm
- Trig pulse width: 10μs
- Echo pulse width: proportional to distance

HC-SR04 Ultrasonic Sensor Working, Pinout, Features & Datasheet (https://components101.com/sensors/ultrasonic-sensor-working-pinout-datasheet)















HC-05 Bluetooth Module Datasheet

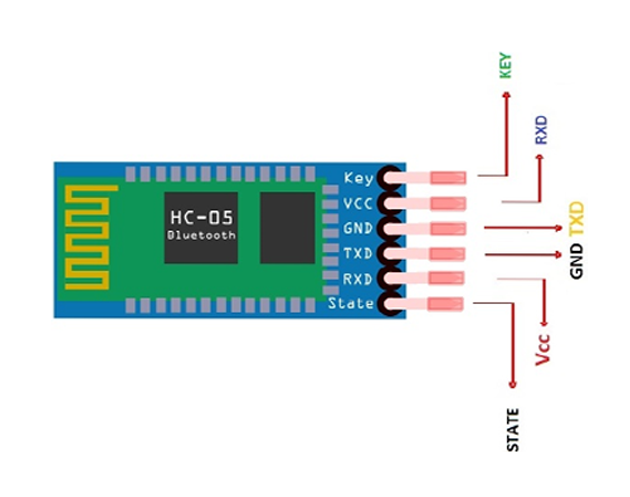
[picture p23: figure]
Interfacing HC-05 Bluetooth Module with Arduino - Electronics 360
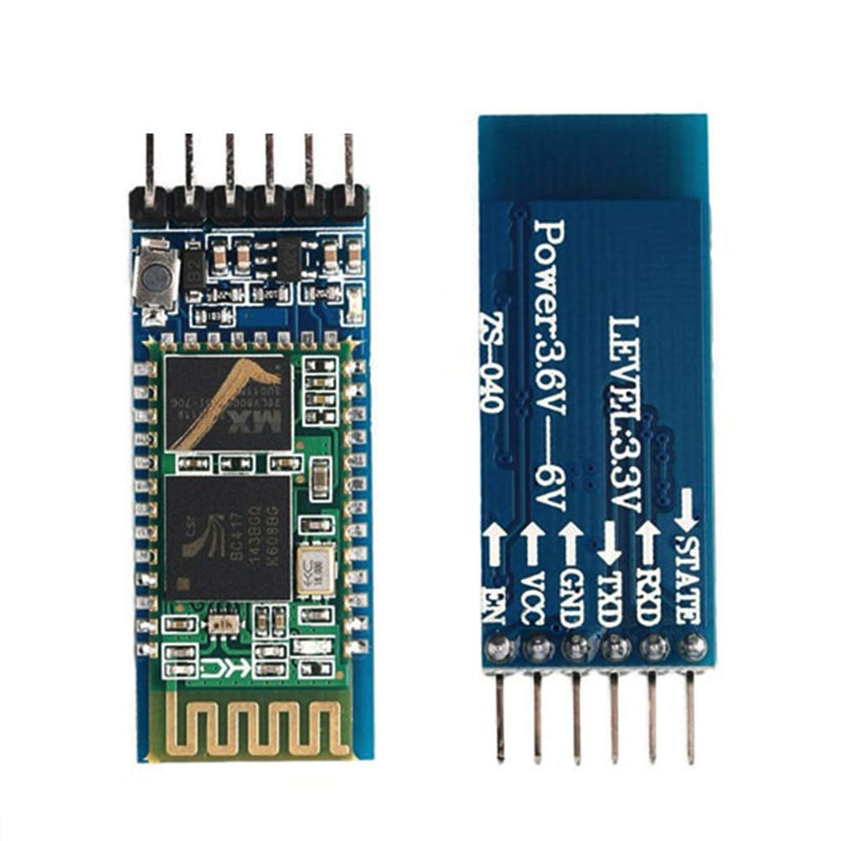
[picture p24: figure]
HC-05 Bluetooth Module - HTE Bangladesh

- Voltage: 3.3V to 5V
- Baud rate: 9600 (default) for data communication and 38400 for command mode communication.
- Communication: Serial (TX/RX)    HC-05 Bluetooth Module Pinout, Datasheet, Features & Applications - The Engineering Projects (https://www.theengineeringprojects.com/2019/10/hc-05-bluetooth-module-pinout-datasheet-features-applications.html)

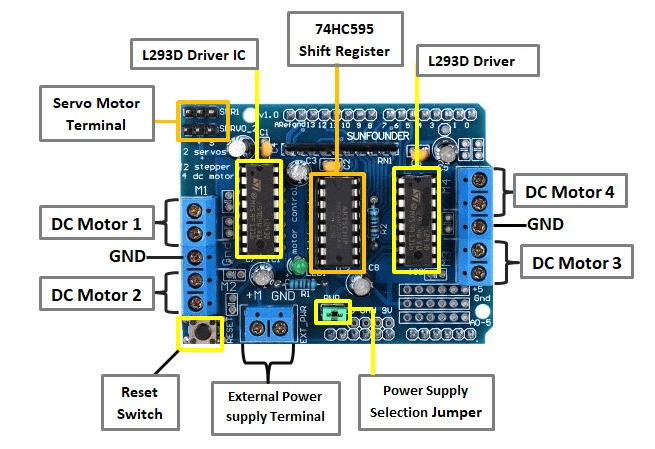
[picture p25: figure]
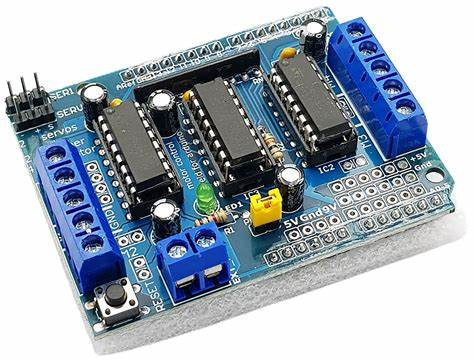
[picture p26: figure]
Arduino Motor Shield L293D - Nshop

L293D Motor Shield – Technical Specifications

- Motor Driver IC: L293D (Quadruple Half-H Driver)
- Operating Motor Voltage: 4.5V to 36V
- Logic Voltage: 5V (supplied via Arduino)
- Maximum Current: 600 mA per channel (peak up to 1.2 A)
- Motor Control Capability:
  - Supports up to 4 DC motors (bidirectional control)
  - Supports up to 2 stepper motors
- Speed Control: Pulse Width Modulation (PWM) supported
- External Power Supply: Screw terminal for motor power (recommended 6–12V)
- Control Interface: Digital I/O pins (IN1–IN4, ENA, ENB)
- Servo Support: Two servo headers (Arduino pins 9 and 10)
- Compatibility: Designed for Arduino Uno, Mega, and similar boards   L293D Motor Shield.pdf (https://www.handsontec.com/dataspecs/module/L293D%20Motor%20Shield.pdf)

Appendix C – Applications Used for Arduino Bluetooth Control

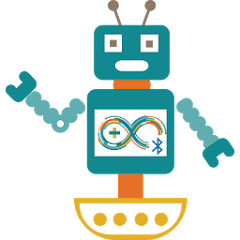
[picture p27: figure]

1. Arduino BlueControl

(https://play.google.com/store/apps/details?id=com.broxcode.arduinobluetoothfree)
With Arduino Bluetooth Control, we can customize our own voice commands and use them to control all microcontroller-based boards. We obtained the commands specified in our code using these configurations.

Settings + Vocal Commands Configurations

Welcoming page:

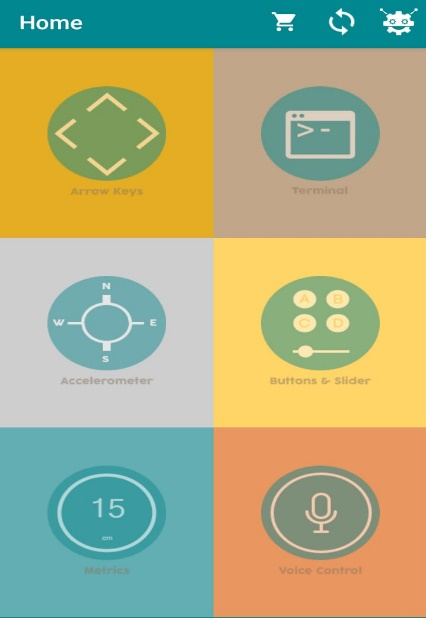
[picture p28: figure]

Voice Control Once Connected to the Device

Scan/Select/Connect the Bluetooth Module

Settings:

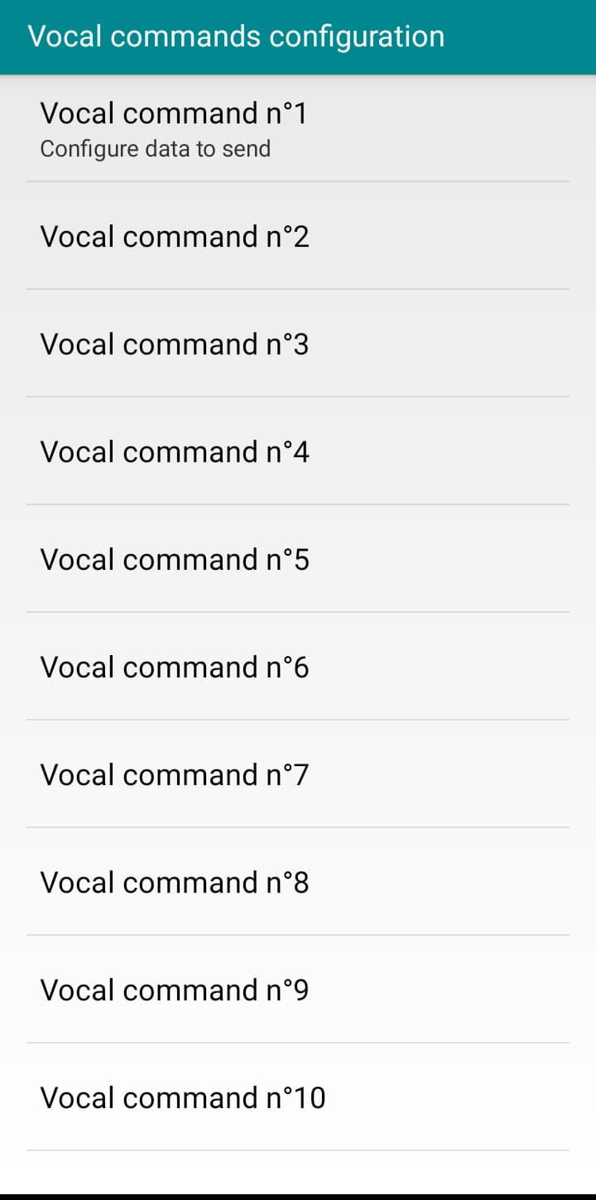
[picture p29: figure]
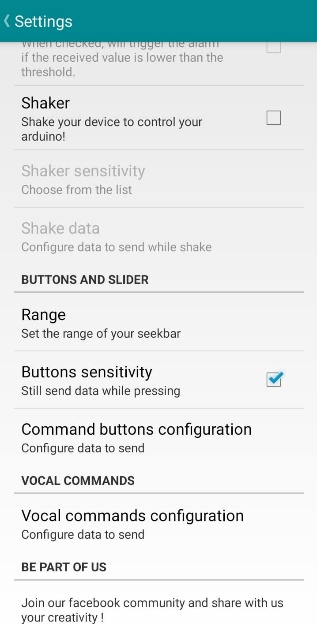
[picture p30: figure]

Each Command and Its Configuration: Voice Command & Data to Send

Go:

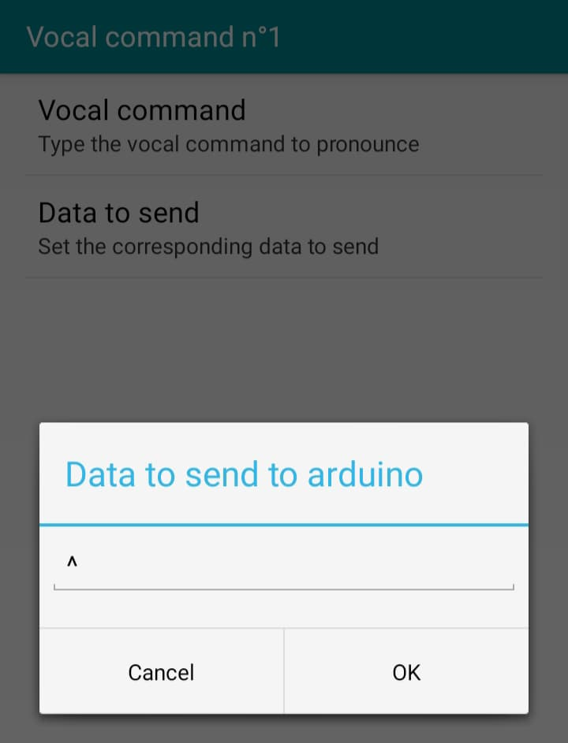
[picture p31: figure]
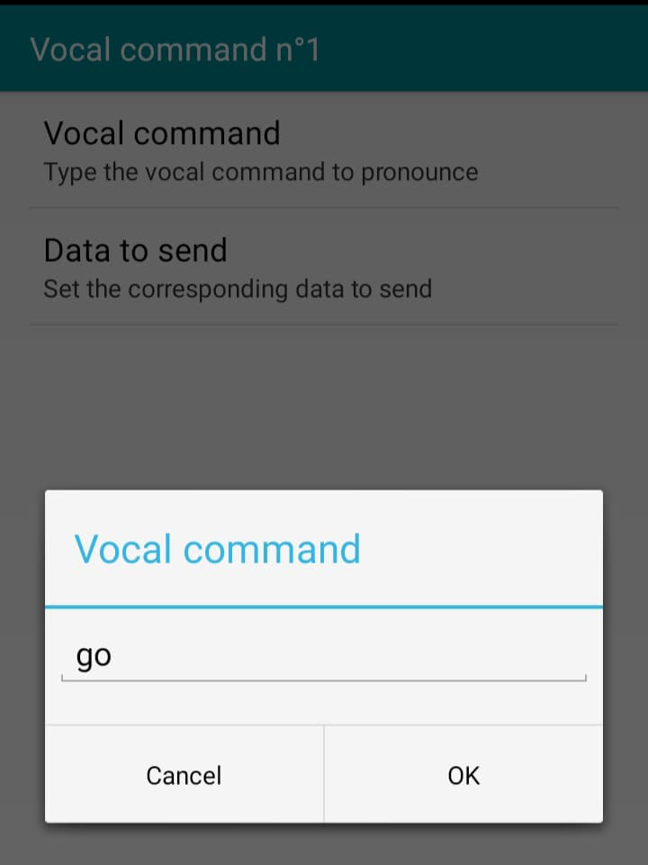
[picture p32: figure]

Back:

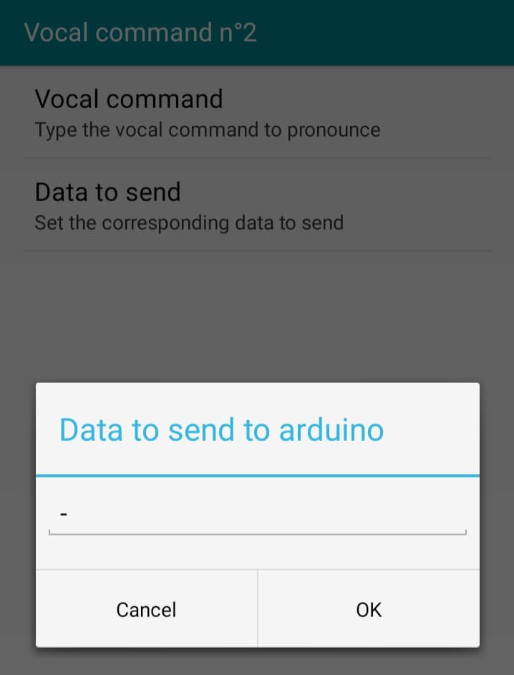
[picture p33: figure]
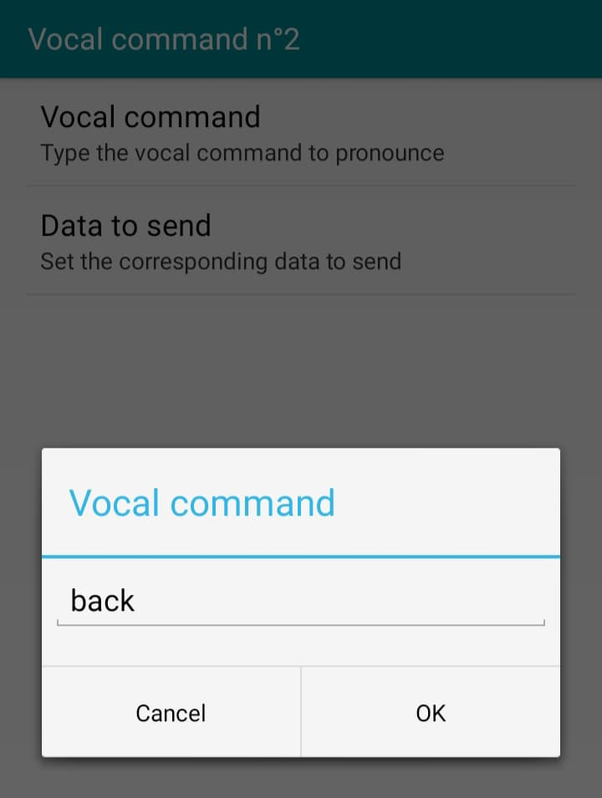
[picture p34: figure]

Left:

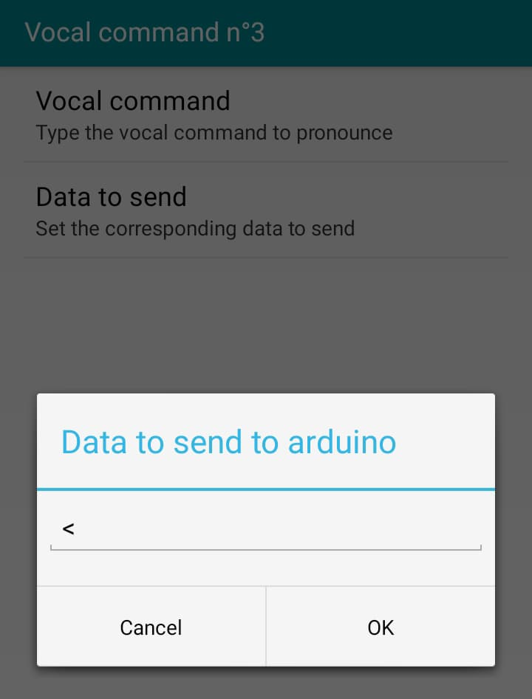
[picture p35: figure]
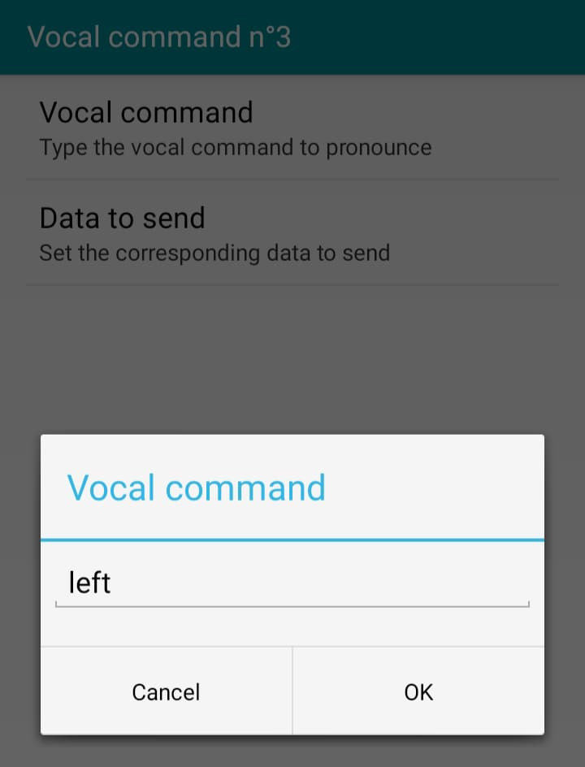
[picture p36: figure]

Right:

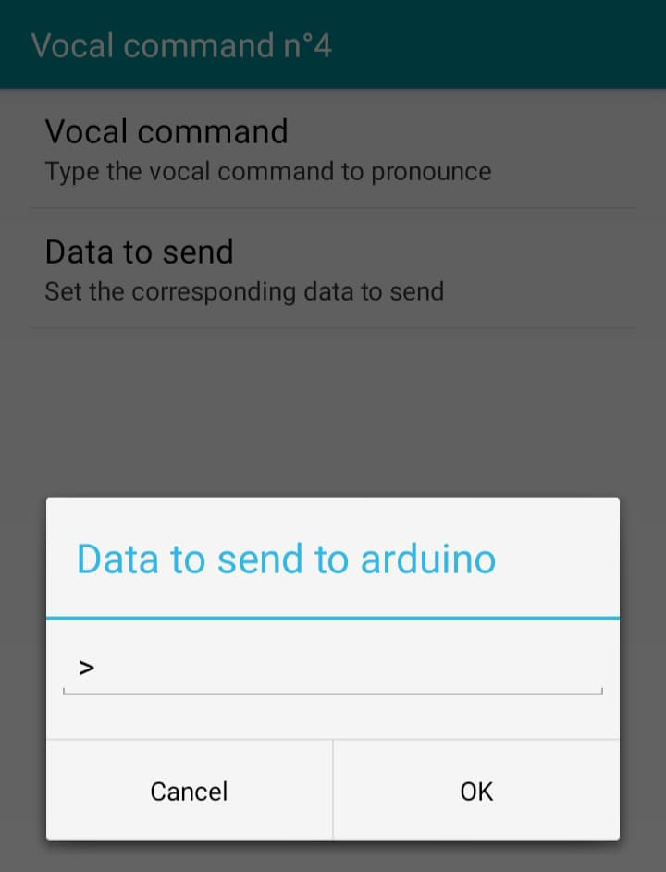
[picture p37: figure]
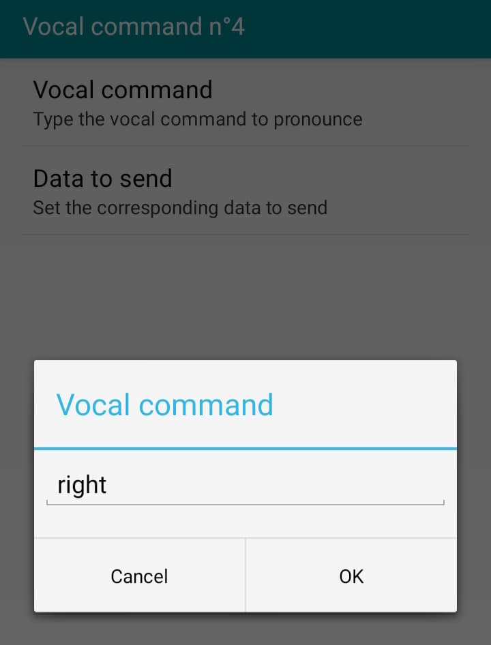
[picture p38: figure]

Stop:

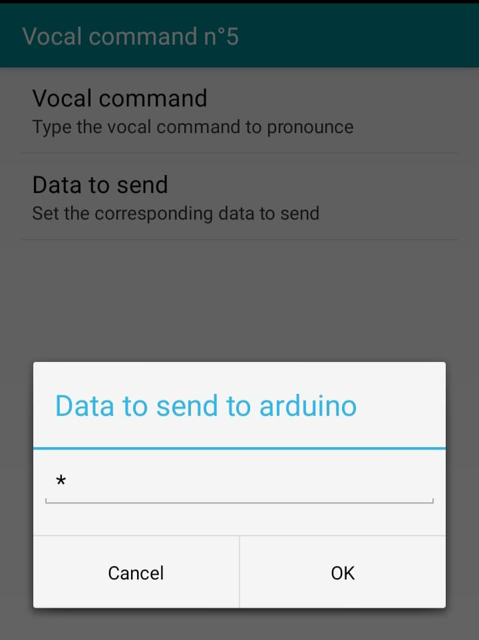
[picture p39: figure]
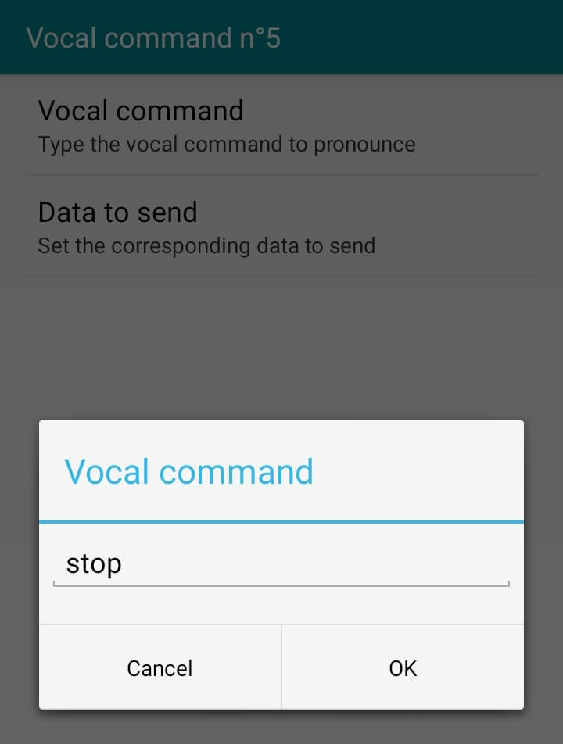
[picture p40: figure]
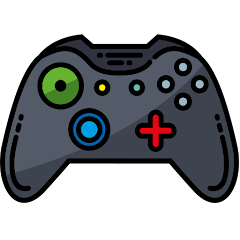
[picture p41: figure]

2. RC Bluetooth Controller (https://play.google.com/store/apps/details?id=com.SanitTech.RCBluetoothControllerHC05) RC Bluetooth Controller (HC-05) is an app designed to control an RC car using the HC-05 Bluetooth module. This app provides Arduino source code and allows you to control your RC car via an Android device. It has the simplest user interface and did not cause any problems during use.

Scan/Select the Bluetooth Module

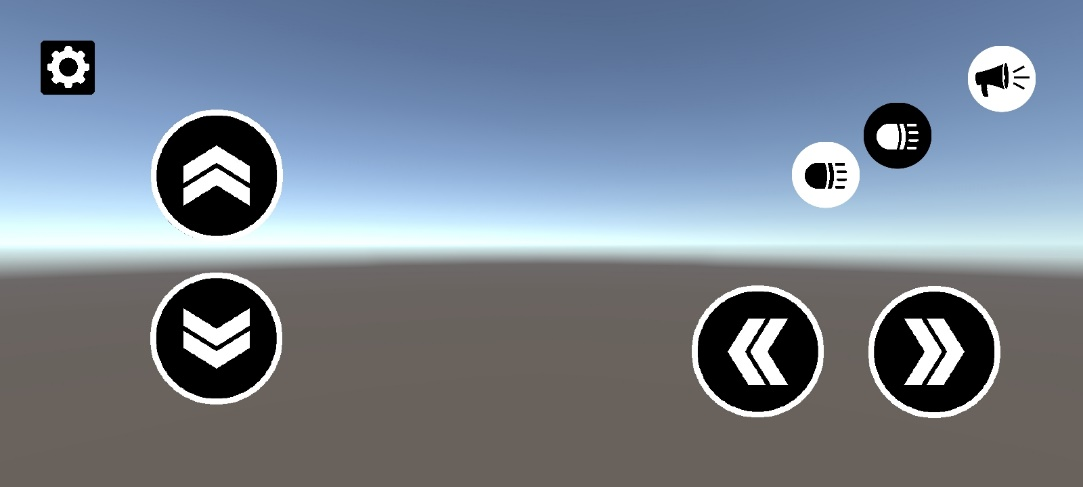
[picture p42: figure]
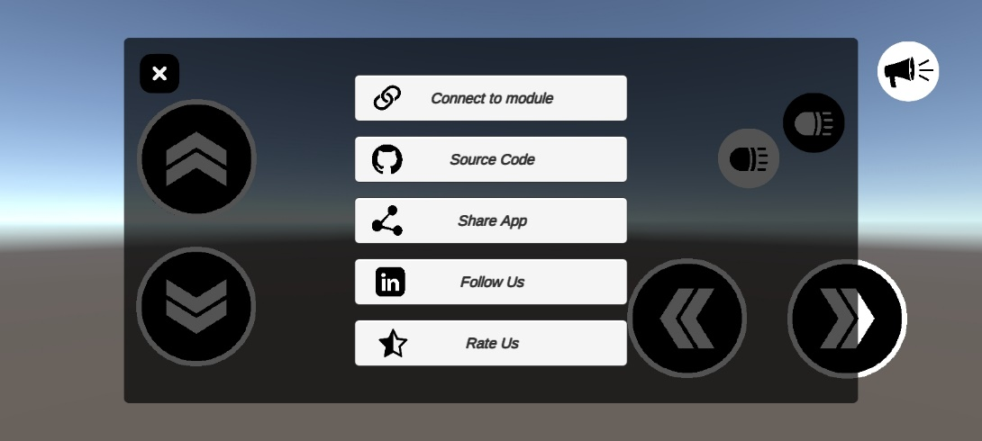
[picture p43: figure]
