maysamsgx/one-robot-speak-control-avoid/Sir Avoids-a-Lot (bird’s eye view).jpeg

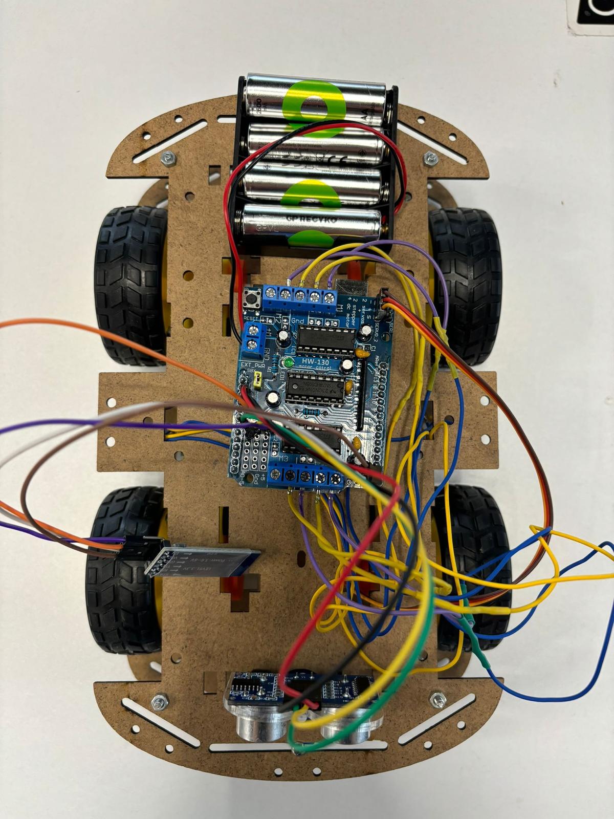
Sir Avoids-a-Lot (bird’s eye view).jpeg
